voidash/fpga-console/README.md

# FPGA-Console 
<center>
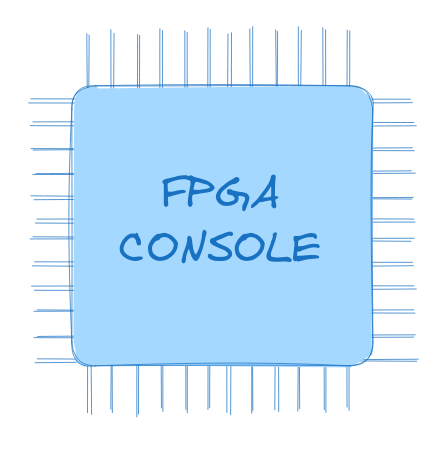
[picture p1: screenshots/logo.png]
    
</center>

## A Simple Game Console built from the Ground Up, from its CPU design to game design using FPGA

- Using Tang Nano 9k FPGA, custom CPU is created
- ESP8266 and SSD1306 acts as a Screen controller. ESP8266 and SSD1306 communicate with I2C protocol
- Uses OSS-CAD tools
- CPU and screen controller talks with each other through UART. 
- FPGA and flash memory communicates using SPI protocol
- FPGA and display module communicates using UART 

# Tools and Stuff

- **FPGA used** : Tang Nano 9k
- **Screen** : SSD1306
- **Synthesis** : Yosys,synth_gowin
- **place and Route**: nextpnr-gowin
- **Bitstream generator**: gowin_pack
- **load**: openFPGALoader
- **Assembler**: Written In Rust

# CPU 

> You need OSS-CAD-SUITE

- load CPU into FPGA
    `cd cpu; make all`
- flash your game to FPGA
    `openFPGALoader -b tangnano9k --external-flash ./cpu/games/pong.bin`

- To verify specific module
    `iverilog ./cpu/uart.v; vvp a.out; gtkwave new_created.vcd`

<center>
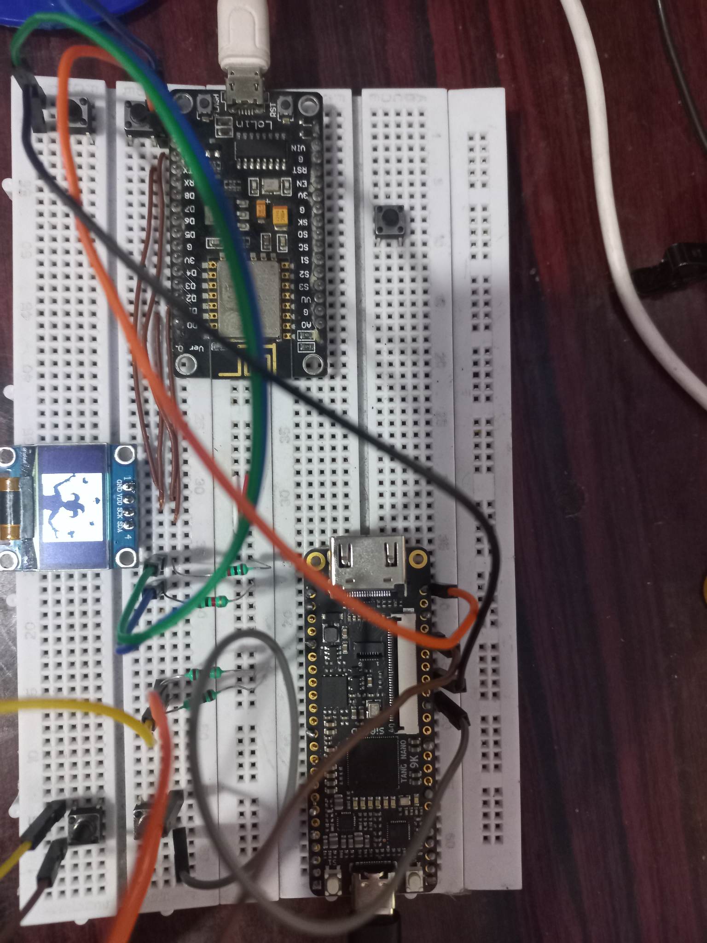
[picture p2: sem_project_report/images/fpga_bhoos.jpg]
    
    <h4>Fig: FPGA in Action</h4>
</center>

## Architecture of CPU

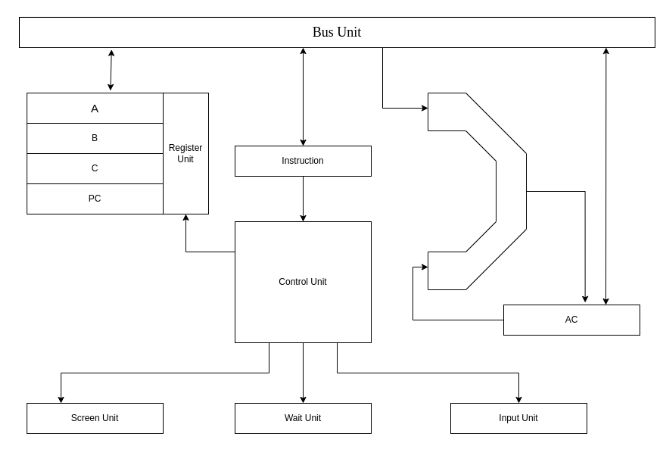
[picture p3: screenshots/architecture.png]

<h4>Fig: Architecture of CPU </h4>

--------------

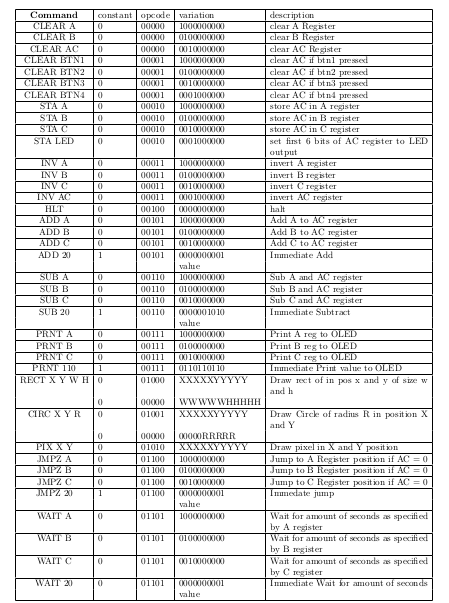
[picture p4: screenshots/ISA-table.png]

<h4>Table: ISA Table</h4>

--------------

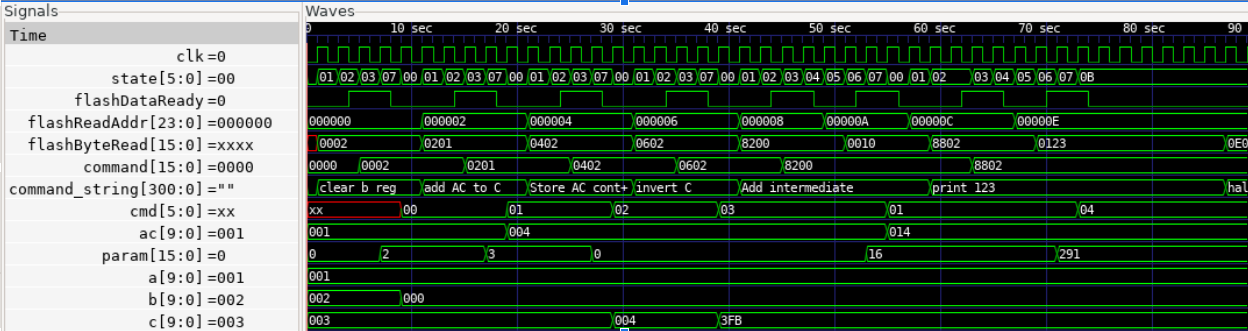
[picture p5: screenshots/timing.png]

<h4>Timing Diagram for CPU</h4>

## Schematic Diagram

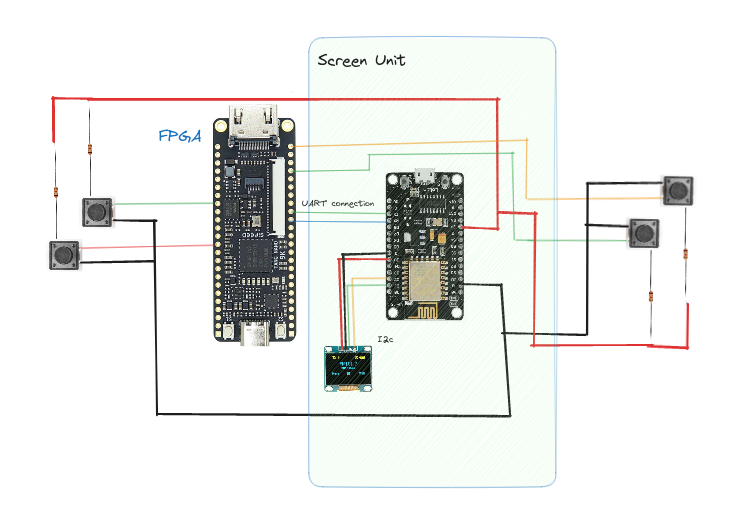
[picture p6: screenshots/schematic.png]
