voidash/fpga-console/uart/README.md

- With UART you send data from one device to another over a single wire. 
- You need to agree upon the baud rate. 
- tang nano 9k supports JTAG and UART
