voidash/fpga-console/semester-report/main.tex

\documentclass[a4paper,12pt]{article}

\usepackage{graphicx}
\usepackage{hyperref}
\usepackage{multibib}
\usepackage{fancyhdr}
\usepackage{float}

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

\fancyhf{} % clear all header and footers
\renewcommand{\headrulewidth}{0pt} % remove the header rule
\rfoot{\thepage}

\newcites{bib}{Bibliography}
\newcites{ref}{References}
\bibliographystyle{apalike}

\pagestyle{fancy}
\begin{document}
\setcounter{secnumdepth}{4} %so that we get subsubsubsection
\setcounter{tocdepth}{4} %so that subsubsubsection get's shown on Table of contents

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

     \\[0.6cm]

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

    { \large \bfseries COMP 342} \\[0.3cm]

    { \normalsize \bfseries for  partial fullfullment of III/II in Computer Science/Engineering} \\[0.6cm]

    \textbf{\large Submitted By} \\[0.2cm]

    \textbf{\large Ashish Thapa(56)}

    \textbf{\large Aditya Jha(20)} \\[1.2cm]

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

    \textbf{\large Submission Date:} \\[0.3cm]
    \today
\end{center}

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

    \newpage
    \section*{Abstract}
    \addcontentsline{toc}{section}{Abstract}

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

    \newpage
    \pagenumbering{gobble}
    \tableofcontents

    % defining list of figures and list of tables

    \newpage
    \listoffigures
    \addcontentsline{toc}{section}{List of Figures}
    \pagenumbering{Roman}
    \setcounter{page}{3}

    \newpage
    \listoftables
    \addcontentsline{toc}{section}{List of Tables}
    \newpage

    % abbreviation

    \section*{Abbreviation} 
    \addcontentsline{toc}{section}{Abbreviation}
    \renewcommand{\arraystretch}{2.3}
    \label{tab:acronyms}
    \begin{tabular}{|c|p{0.7\linewidth}|}
    \hline
    \textbf{Acronym} & \textbf{Description} \\
    \hline
    FPGA & Field-Programmable Gate Array \\
    ISA & Instruction Set Architecture \\
    OLED & Organic Light Emitting Diode \\
    ESP & Electronic Stability Program \\
    UART & Universal Asynchronous Receiver-Transmitter \\
    SPI & Serial Peripheral Interface \\
    I2C & Inter-Integrated Circuit \\
    CPU & Central Processing Unit \\
    VGA & Video Graphics Array \\
    HDL & Hardware Description Language \\
    DSA & Domain Specific Architecture\\
    RISC & Reduced Instruction Set Architecture\\
    CISC & Complex Instruction Set Architecture\\
    \hline
    \end{tabular}

    % main matter
    \newpage
    \pagenumbering{arabic}
    \setcounter{page}{1}
    \section{Introduction}
    \subsection{Background}

    \phantom{}

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

    \subsection{Consoles}

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

    \subsubsection{FPGA-CHIP8} 
    CHIP-8 is a virtual machine with an interpreted environment widely used in the 1970s.
    FPGA-CHIP8 implements CHIP-8 specification for TinyFPGA BX board. Other hardware components are a 16-button keyboard and 128x64px monochrome OLED screen
    \newpage
    \begin{figure}[h]
    \centering
     
    \caption{FPGA-CHIP8 running Space invaders}
    \end{figure}

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

    \subsubsection{Learning Communication Interfaces}
    \paragraph{Interfacing with flash memory with SPI interface}
    \paragraph{Interfacing with Screen using UART interface}
    \subsubsection{Building the CPU}
    \subsubsection{Writing Assembly Code for Games}

    \newpage

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

    \newpage

    Instruction set architecture defines 
    \begin{itemize}
        \item instruction set: the function of each instruction
        \item Register set : how many registers there are , size of registers, functions and its initial state
        \item Exception Model: What are the different level of privilege 
        \item Memory Model 
    \end{itemize}
    \newpage
    \subsection{Diagrams}
    
    \begin{figure}[h]
    \begin{tikzpicture}[shorten >=1pt,node distance=2.5cm,auto]
    \tikzstyle{every state}=[fill={rgb:black,1;white,10}]

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

    \path[->]
    (idle) edge [bend right] node {} (startbit)
    (startbit) edge node {} (write)
    (write) edge [bend left] node {} (stop)
    (stop) edge [bend left] node {$all\ bytes\ not\ transferred$} (startbit)
    (stop) edge [bend left] node {$all\  bytes\ transferred$} (debounce);
    \end{tikzpicture}
    \caption{State diagram for UART Protocol} 
    \end{figure}
% SPI
    \begin{figure}[h!]
    \begin{tikzpicture}[shorten >=1pt,node distance=3cm,auto]
    \tikzstyle{every state}=[fill={rgb:black,1;white,10}]

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

    \newpage

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

    \begin{figure}[h]
    \setlength{\unitlength}{0.8cm}
    \begin{picture}(16,1)
    \multiput(0,0)(0,1){2}{\line(1,0){16}}
    \multiput(0,0)(1,0){17}{\line(0,1){1}}
    \put(0,-1){\line(1,0){1}}
    \put(0,-1){\line(0,1){1}}
    \put(0.1,-0.7){$CM$}
    \put(1,-1){\line(0,1){1}}
    
    \put(1,-1){\line(1,0){5}}
    \put(1,-1){\line(0,1){1}}
    \put(1.2,-0.7){$COMMANDS$}
    \put(6,-1){\line(0,1){1}}
    
    \put(6,-1){\line(1,0){10}}
    \put(6,-1){\line(0,1){1}}
    \put(6.2,-0.7){$VARIATION$}
    \put(16,-1){\line(0,1){1}}
    \end{picture}
    \vspace{0.4cm}
    \caption{ISA}
    \end{figure}

    \subsection{System Requirement Specification}
    \subsubsection{Software specification}
    \paragraph{Verilog}
    \paragraph{Yosys}
    \paragraph{gowith-pnr}
    \subsubsection{Hardware specification}

    \newpage
    \section{Discussion on Achievements}

    \newpage
    \section{Conclusion and Recommendatation}
    \subsection{Limitation}

    \subsection{Future Enhancement}

    hello leslie lamport \citebib{Herlocker:2004}
     hello leslie lamport \citebib{HuLiu:2004}

    hello leslie lamport \citeref{opinion:lexicon}

    \bibliographystylebib{plain}
    \bibliographybib{Bibliography}

    \bibliographystyleref{plain}
    \bibliographyref{References}
\end{document}
