voidash/fpga-console/sem_project_report/fig.pdf

# tikz

ashish.thapa477

May 2023

## 1 Introduction

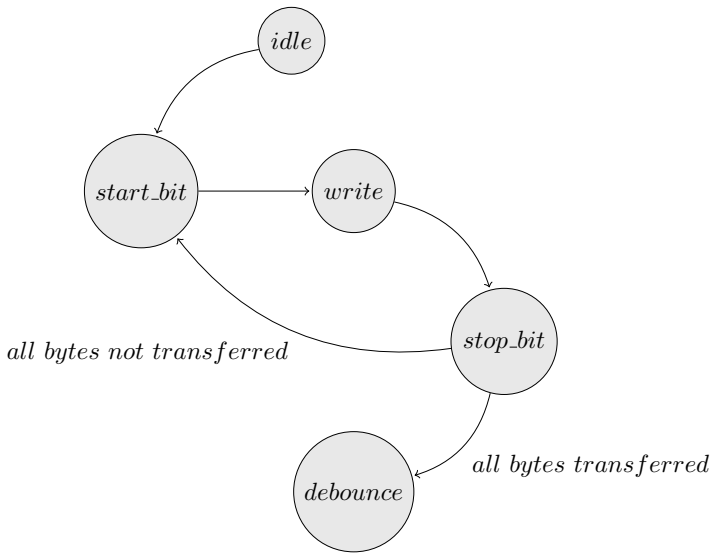
[picture p33: figure]
idle; start bit; write; stop bit; debounce; all bytes not transferred; all bytes transferred

Figure 1: State diagram for UART Protocol

1

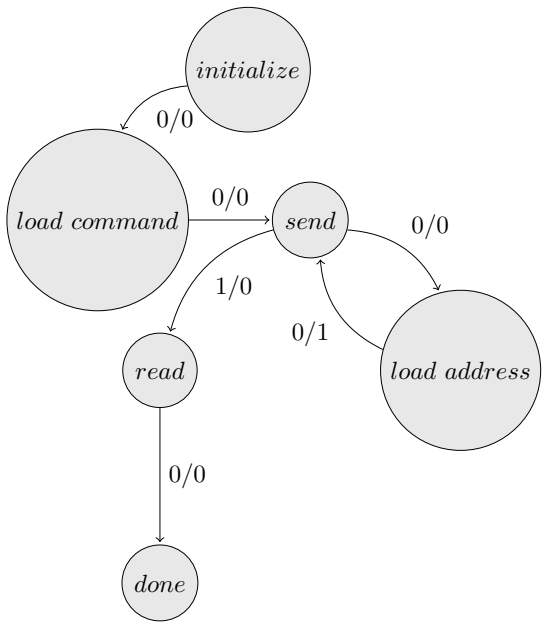
[picture p34: figure]
initialize; load command; send; read; load address; done

Figure 2: State diagram for SPI Flash Protocol

2

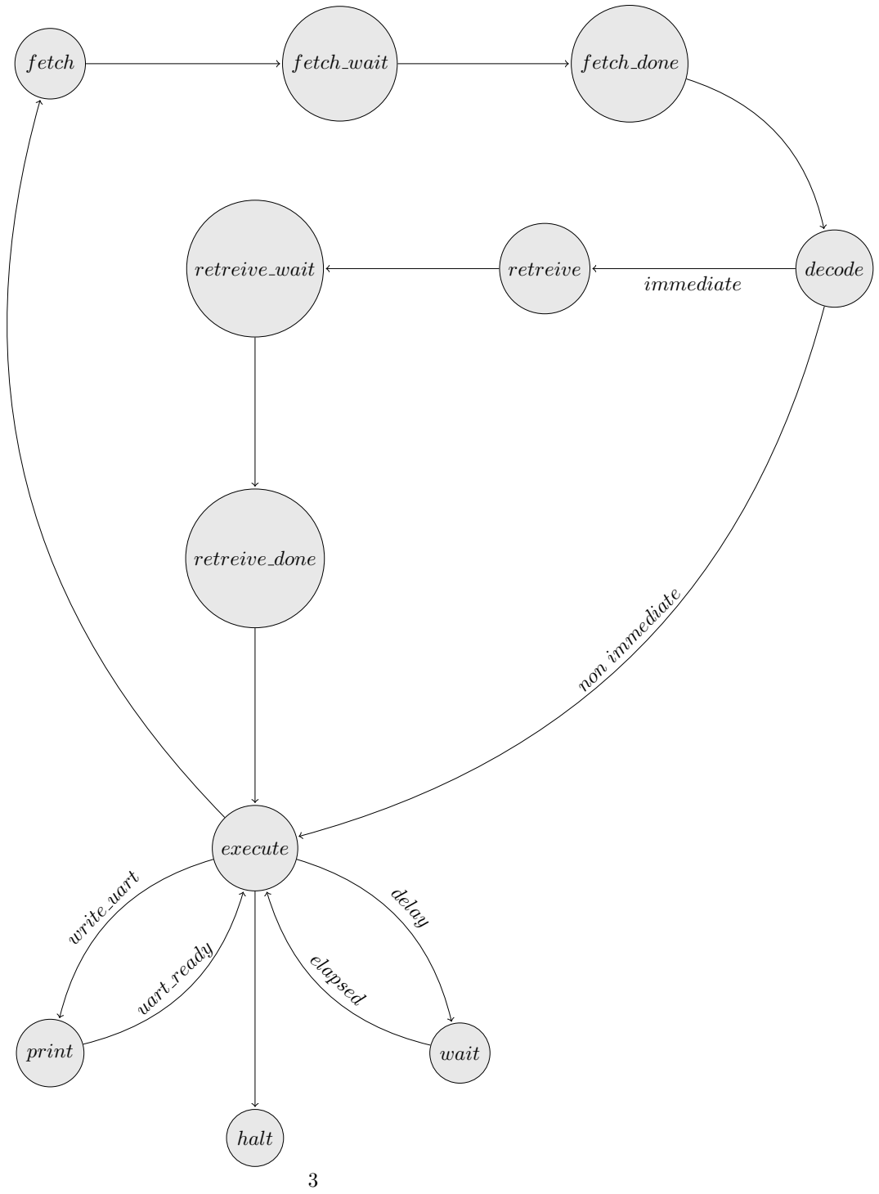
[picture p35: figure]
fetch; fetch wait; fetch done; retreive wait; retreive; decode; retreive done; execute; print; wait; halt; immediate; non immediate; write uart; delay; uart ready; elapsed

Figure 3: State diagram for CPU

CM | COMMANDS | V ARIAT ION

Figure 4: ISA

4
