voidash/fpga-console/sem_project_report/images/spi.jpeg

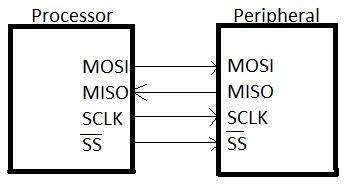
sem_project_report/images/spi.jpeg
