voidash/fpga-console/cpu/screen.ino/screen.ino.ino

#include <Wire.h>
#include <Adafruit_GFX.h>
#include <Adafruit_SSD1306.h>

#define SCREEN_WIDTH 128 // OLED display width, in pixels
#define SCREEN_HEIGHT 64 // OLED display height, in pixels

// Declaration for an SSD1306 display connected to I2C (SDA, SCL pins)
Adafruit_SSD1306 display(SCREEN_WIDTH, SCREEN_HEIGHT, &Wire, -1);

const PROGMEM uint8_t image[] = {
  0x00, 0x00, 0x00, 0x3f, 0xff, 0xff, 0xff, 0xff, 0xff, 0xff, 0xff, 0xff, 0xfe, 0x00, 0x00, 0x00, 
	0x00, 0x00, 0x00, 0x3f, 0xff, 0xff, 0xff, 0x3f, 0xff, 0xff, 0xff, 0xff, 0xfe, 0x00, 0x00, 0x00, 
	0x00, 0x00, 0x00, 0x3f, 0xff, 0xff, 0xfe, 0x0f, 0xff, 0xff, 0xff, 0xff, 0xfe, 0x00, 0x00, 0x00, 
	0x00, 0x00, 0x00, 0x3f, 0xff, 0xff, 0xfc, 0x07, 0xff, 0xff, 0xff, 0xff, 0xfe, 0x00, 0x00, 0x00, 
	0x00, 0x00, 0x00, 0x3f, 0xff, 0xff, 0xf8, 0x03, 0xff, 0xff, 0xff, 0xff, 0xfe, 0x00, 0x00, 0x00, 
	0x00, 0x00, 0x00, 0x3f, 0xff, 0xff, 0xf8, 0x03, 0xff, 0xff, 0xff, 0xff, 0xfe, 0x00, 0x00, 0x00, 
	0x00, 0x00, 0x00, 0x3f, 0xff, 0xff, 0xf8, 0x07, 0xff, 0xff, 0xff, 0xff, 0xfe, 0x00, 0x00, 0x00, 
	0x00, 0x00, 0x00, 0x3f, 0xff, 0xff, 0xfc, 0xbf, 0xff, 0xff, 0xff, 0xff, 0xfe, 0x00, 0x00, 0x00, 
	0x00, 0x00, 0x00, 0x3f, 0xff, 0xff, 0xff, 0x9f, 0xff, 0xff, 0xe3, 0xff, 0xfe, 0x00, 0x00, 0x00, 
	0x00, 0x00, 0x00, 0x3f, 0xff, 0xff, 0xff, 0x9f, 0xff, 0xff, 0x03, 0xff, 0xfe, 0x00, 0x00, 0x00, 
	0x00, 0x00, 0x00, 0x3f, 0xff, 0xff, 0xff, 0xff, 0xff, 0xff, 0x03, 0xff, 0xfe, 0x00, 0x00, 0x00, 
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
      int ji = message.indexOf(' ',ti)+1;
      int w = message.substring(ji, message.indexOf(' ', ji)).toInt();
      int h = message.substring(message.lastIndexOf(' ')).toInt();

      Serial.println(x);
      Serial.println(y);
      Serial.println(w);
      Serial.println(h);

      // Draw the rectangle
      display.drawRect(x, y, w, h,WHITE);
    }
    else if (message.startsWith("circ")) {
      // Parse the circle parameters
      int fi = message.indexOf(' ');
      // int x = message.substring(5, fi).toInt();
      int si = message.indexOf(' ', fi) + 1;
      int x = message.substring(si, message.indexOf(' ',si)).toInt();
      int ti = message.indexOf(' ',si) +1;
      int y = message.substring(ti, message.indexOf(' ', ti)).toInt();
      int r = message.substring(message.lastIndexOf(' ')).toInt();

      Serial.println(x);
      Serial.println(y);
      Serial.println(r);
      // Draw the circle
      display.drawCircle(x, y, r,WHITE);
    }
    else if (message == "clear") {
      // Clear the screen
      display.clearDisplay();
    }
  }
  
 
  display.display();
}
