voidash/fpga-console/misc/finite-machine.v

module fsm (
    clk,
    reset,
    go,
    kill,
    done
);
input clk;
input reset;
input go;
input kill;
output done;

reg[6:0] count=7'd000;
reg done;
reg[1:0] state_reg;

parameter idle = 2'b00;
parameter active = 2'b01;
parameter finish = 2'b10;
parameter abort = 2'b11;

always @(posedge clk or posedge reset)
begin
    if (reset)
        state_reg <= idle;
    else 
        case (state_reg)
            idle:
                if (go) state_reg <= active;
            active: 
                if (kill) state_reg <= abort;
                else if(count == 7'd100) state_reg <= finish;
            finish:
                state_reg <= idle;
            abort: if(!kill) state_reg <= idle;
            default: state_reg <= idle;
        endcase
end

always @(posedge clk or posedge reset)
begin
    if (reset)
        count <= 7'h00;
    else if (state_reg == finish || state_reg == abort)
        count <= 7'h00;
    else if(state_reg == active)
        count <= count + 7'd20;
end

always @(posedge clk or posedge reset)
begin
    if (reset)
        done <= 1'b0;
    else if (state_reg == finish)
        done <= 1'b1;
    else 
        done <= 1'b0;
end
endmodule


module fsm_tb;

reg    clk;
reg    reset;
reg    go;
reg    kill;
wire    done;

fsm UUT(
    .clk(clk),
    .reset(reset),
    .go(go),
    .kill(kill),
    .done(done)
);

initial begin
    $dumpfile("fsm.vcd");
    $dumpvars(0,fsm_tb);
    go=1;clk=1;#10;
    clk=0;#10;
    clk=1;#10;
    clk=0;#10;
    clk=1;#10;
    clk=0;#10;
    clk=1;#10;
    clk=0;#10;
    clk=1;#10;
    clk=0;#10;
    clk=1;#10;
end
endmodule
