voidash/fpga-console/misc/combinational_reversal.v

module top_module( 
    input [99:0] in,
    output [99:0] out
);

    always @(*)  
        begin
            integer i;
            for(i=0;i<=99;i=i+1) 
                begin 
                    out[i] = in[99-i];
                end
        end
endmodule
