voidash/fpga-console/(commit log)

2023-02-16 add led blinker
2023-04-27 [add] reverse 99 bit reg with combinational loop, and creation of latch
    [combinational_reversal.v]
2023-05-07 [add] SPI flash
2023-05-08 [add] UART and its corresponding test
2023-05-08 [add] i2c screen interface code
2023-05-09 [add] working flash and uart modules for cpu
2023-05-16 [update] cpu bug fix, [add] cpu test bench for CLEAR and AC
    [cpu.v, cpu_tb.v, screen.ino.ino]
2023-05-19 [update] uart data print simulation
2023-05-21 [add] assembler
2023-05-29 feat: add pong assembly and modify assembler rust
